YusukeKato/original-micromouse/circuit_diagram/block_diagram2.drawio.png

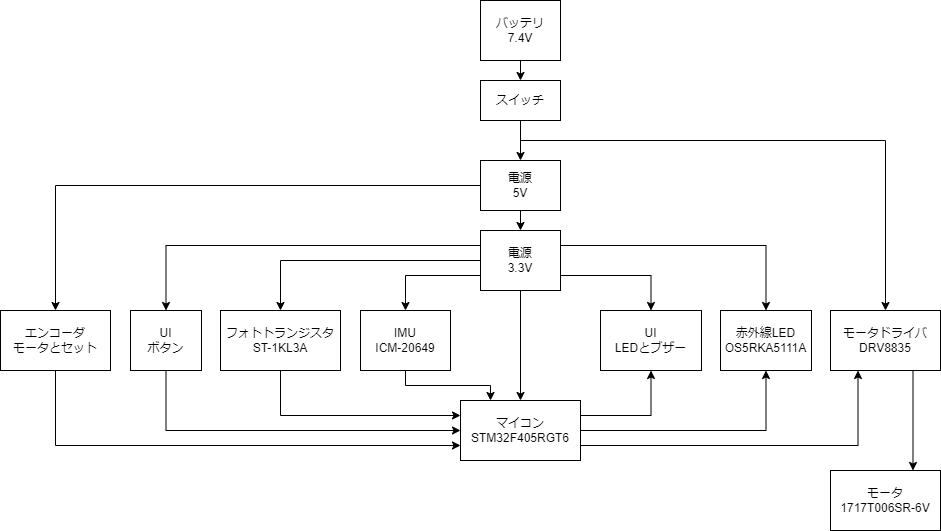
circuit_diagram/block_diagram2.drawio.png
