YusukeKato/original-micromouse/circuit_diagram/circuit_diagram2.png

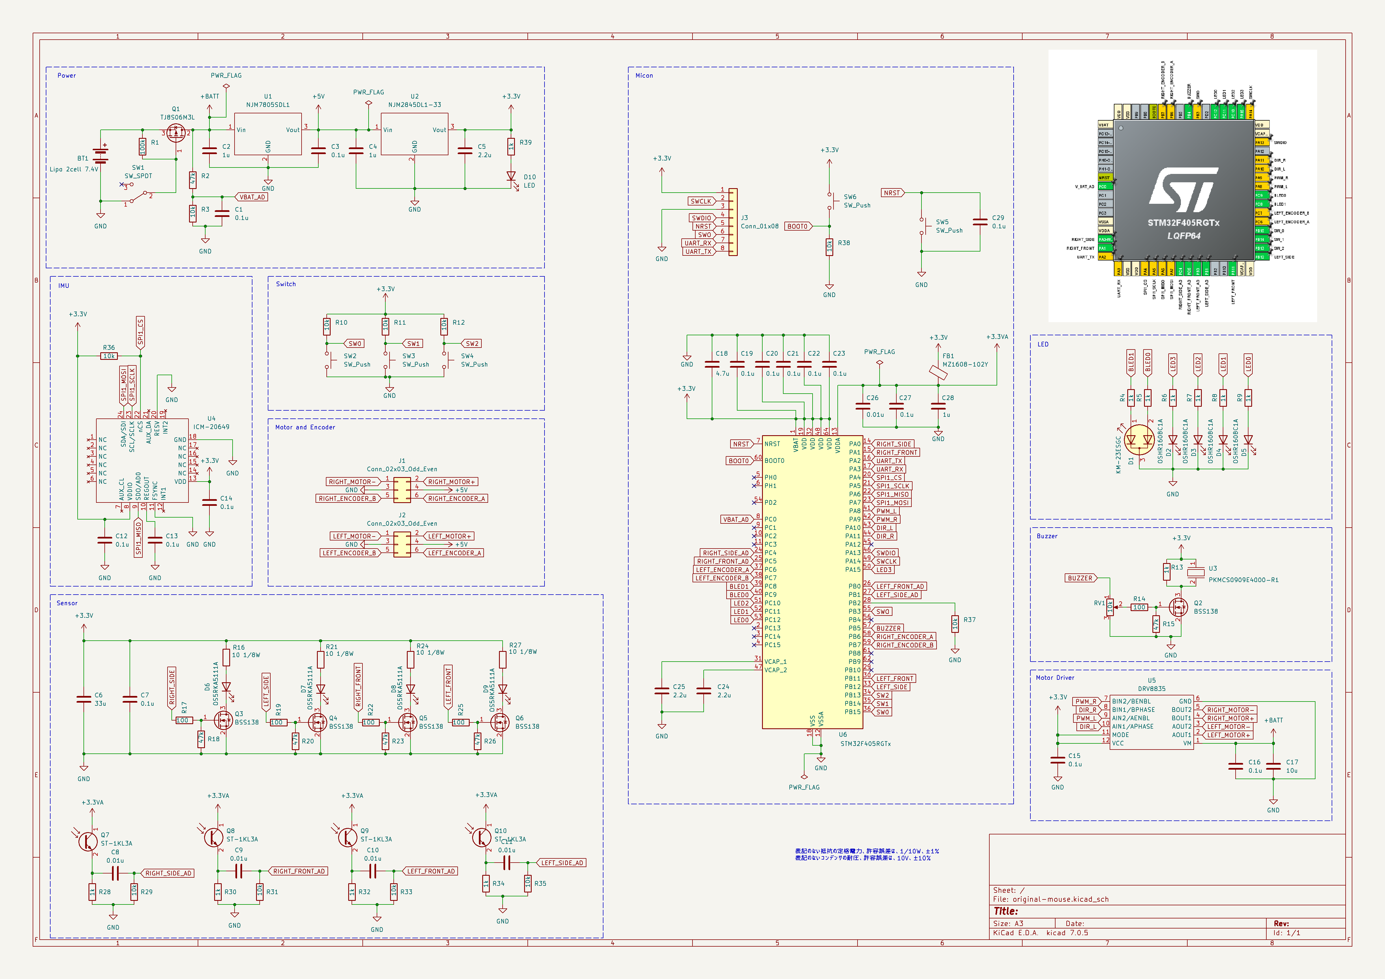
circuit_diagram/circuit_diagram2.png
