YusukeKato/original-micromouse/circuit_diagram/pin_assignment.png

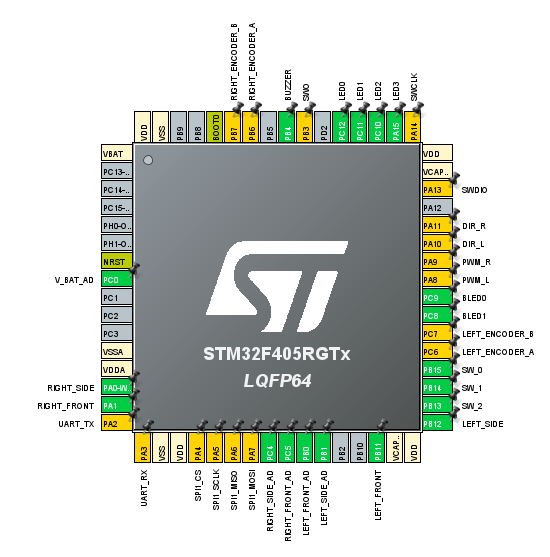
circuit_diagram/pin_assignment.png
