YusukeKato/original-micromouse/circuit_diagram/kiban.dxf

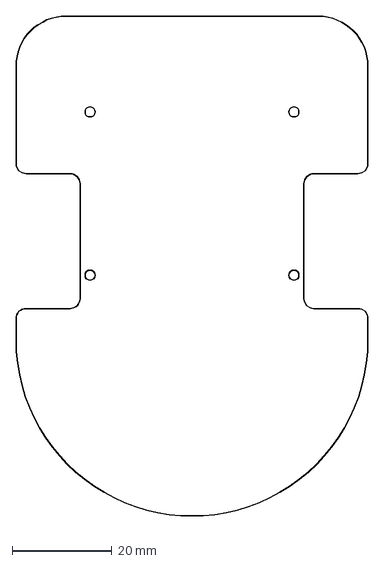
[picture p5: CAD file, 2024-01-30]
circuit_diagram/kiban.dxf
70.4 x 101.6 mm
