YusukeKato/original-micromouse/circuit_diagram/sensor.dxf

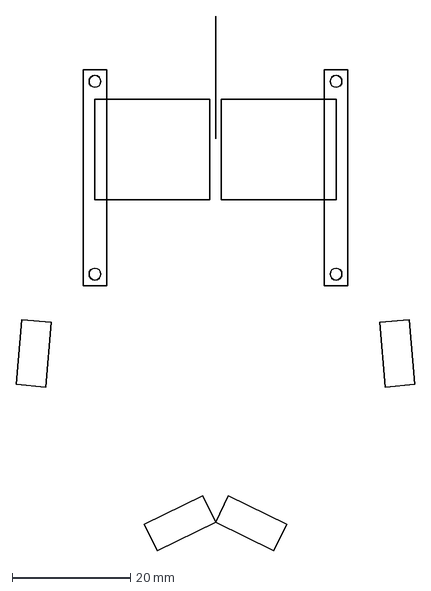
[picture p6: CAD file, 2024-01-30]
circuit_diagram/sensor.dxf
67.5 x 90.4 mm
