YusukeKato/original-micromouse/(threads)

Thread 10 (2023-10-11):

回路図面のレビュー

YusukeKato, 2023-10-11:
KiCadのファイル
https://github.com/YusukeKato/original-micromouse/tree/main/circuit_diagram

回路図面
https://github.com/YusukeKato/original-micromouse/blob/main/circuit_diagram/circuit_diagram.png

KiCadのエレクトリカルルールチェックのエラー
https://github.com/YusukeKato/original-micromouse/blob/main/circuit_diagram/ERC.rpt
