YusukeKato/original-micromouse/(commit log)

2023-06-30 回路のブロック図を作成
2023-07-03 回路のブロック図を追加
2023-09-20 回路図を追加
    [original-mouse.kicad_pcb, original-mouse.kicad_sch]
2023-10-20 エラー解決
    [original-mouse.kicad_sch]
2023-10-25 ピン割り当て図を追加
    [original-mouse.kicad_sch]
2023-10-30 ブザー回路を修正
    [original-mouse.kicad_sch]
2023-12-06 フットプリントの割り当て
    [original-mouse.kicad_sch]
2024-01-30 配線だいたい完了
    [kiban.dxf, original-mouse.kicad_pcb, original-mouse.kicad_sch, sensor.dxf]
2024-01-30 回路図を更新
2024-01-31 配線完了
    [original-mouse.kicad_pcb]
2024-01-31 回路にバージョンを記載
    [original-mouse.kicad_pcb]
2024-02-02 レビューに対応して修正
    [original-mouse.kicad_pcb]
